aecarroll1009/Aj-s-Sunrise-Alarm/cad/out/view_core_front.png

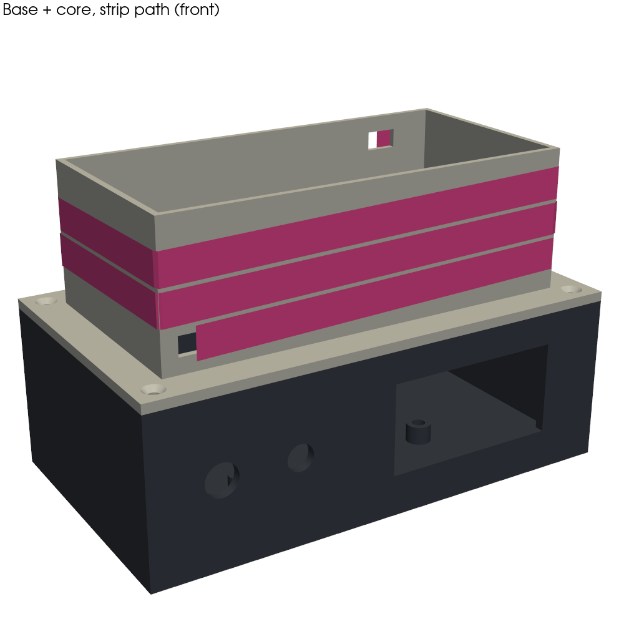
cad/out/view_core_front.png
