aecarroll1009/Aj-s-Sunrise-Alarm/cad/out/view_core_rear.png

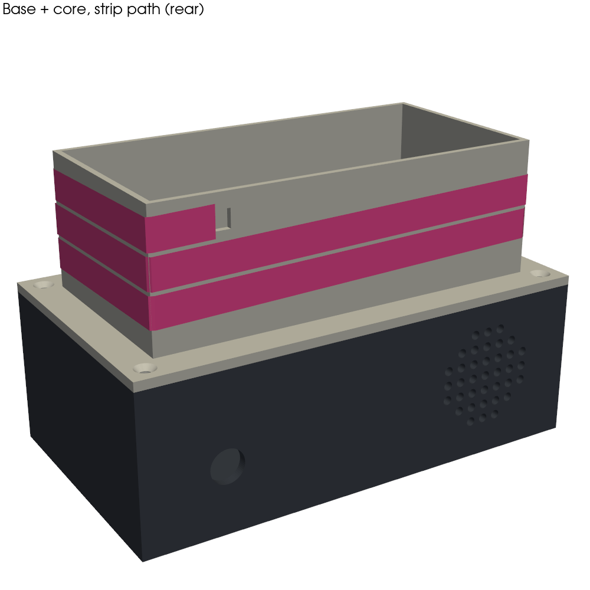
cad/out/view_core_rear.png
