aecarroll1009/Aj-s-Sunrise-Alarm/cad/out/view_exploded.png

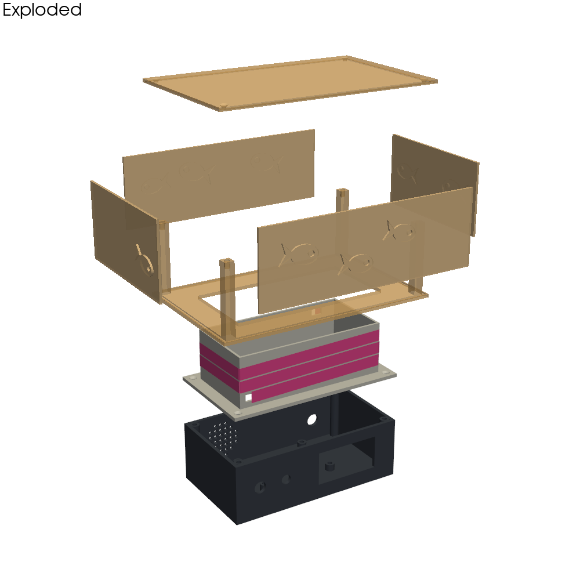
cad/out/view_exploded.png
