aecarroll1009/Aj-s-Sunrise-Alarm/cad/out/view_fish_layout.png

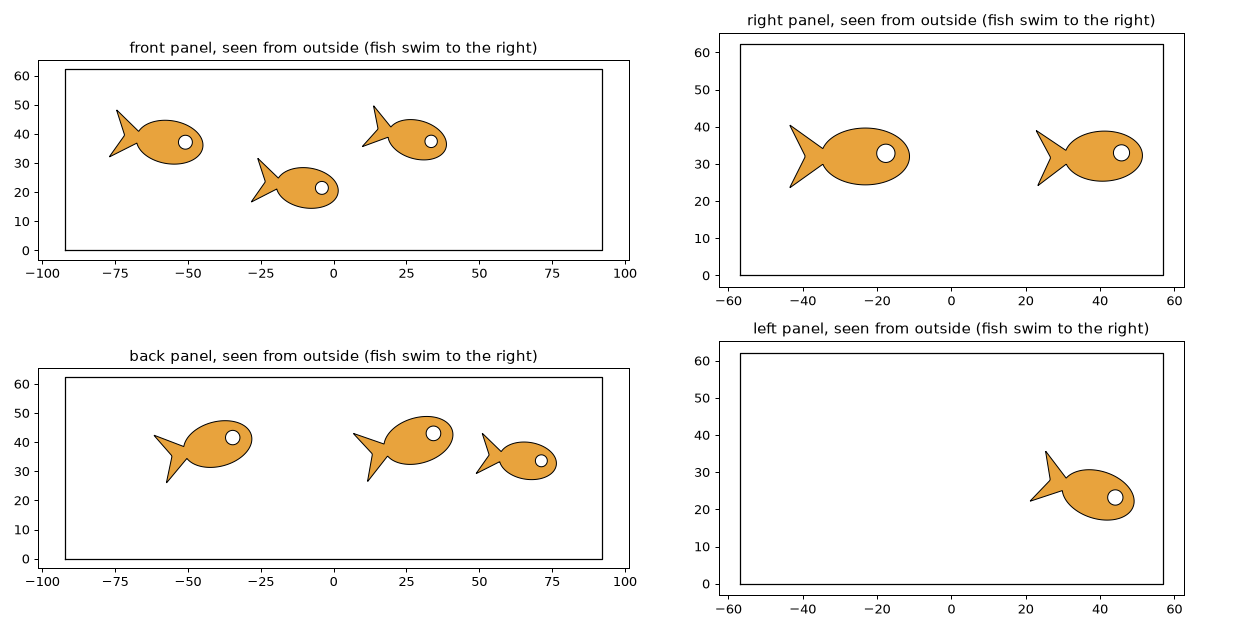
cad/out/view_fish_layout.png
