aecarroll1009/Aj-s-Sunrise-Alarm/cad/out/view_shade_under.png

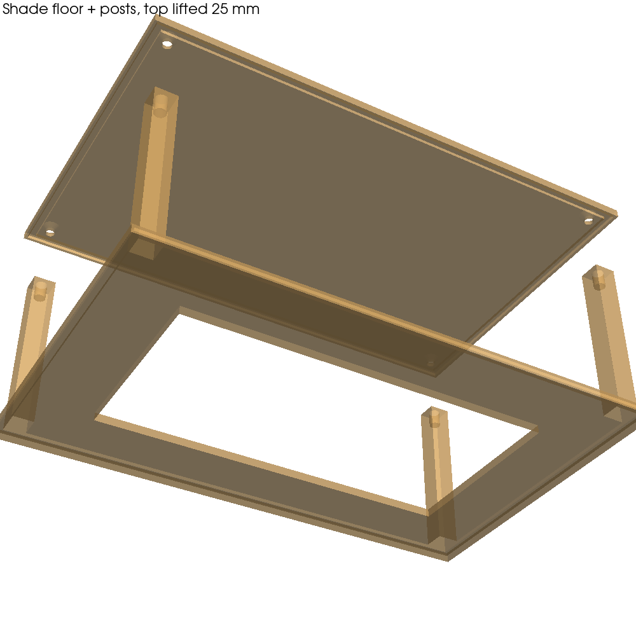
cad/out/view_shade_under.png
