aecarroll1009/Aj-s-Sunrise-Alarm/cad/out/view_side_back.png

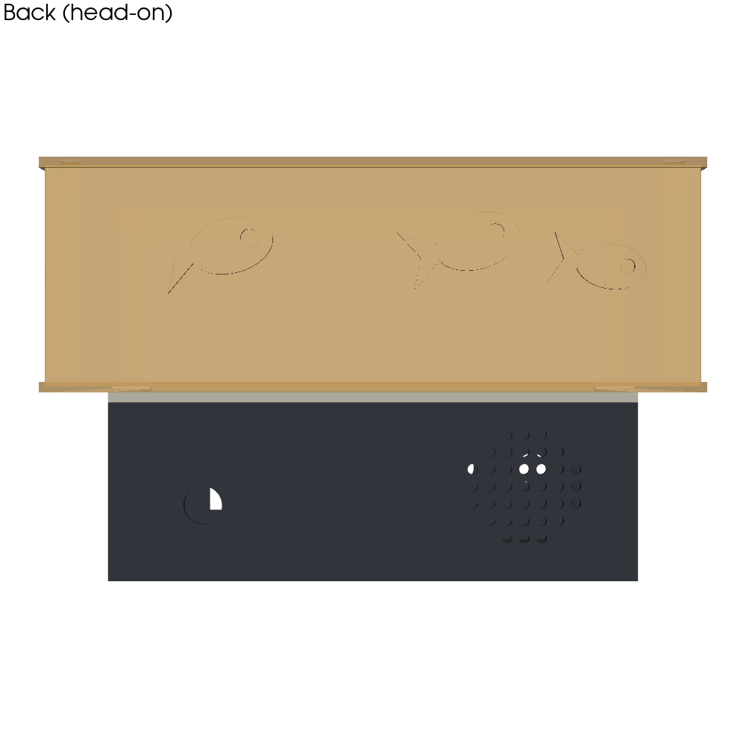
cad/out/view_side_back.png
