aecarroll1009/Aj-s-Sunrise-Alarm/cad/out/view_side_front.png

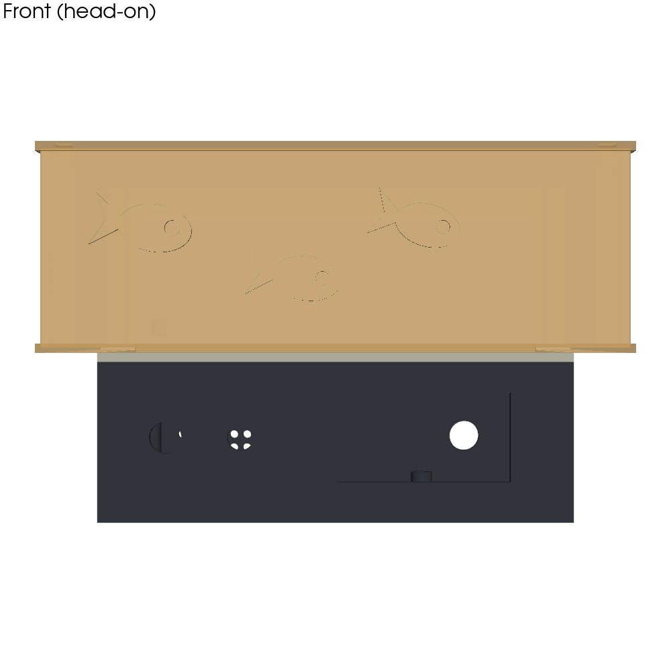
cad/out/view_side_front.png
