aecarroll1009/Aj-s-Sunrise-Alarm/cad/out/view_side_left.png

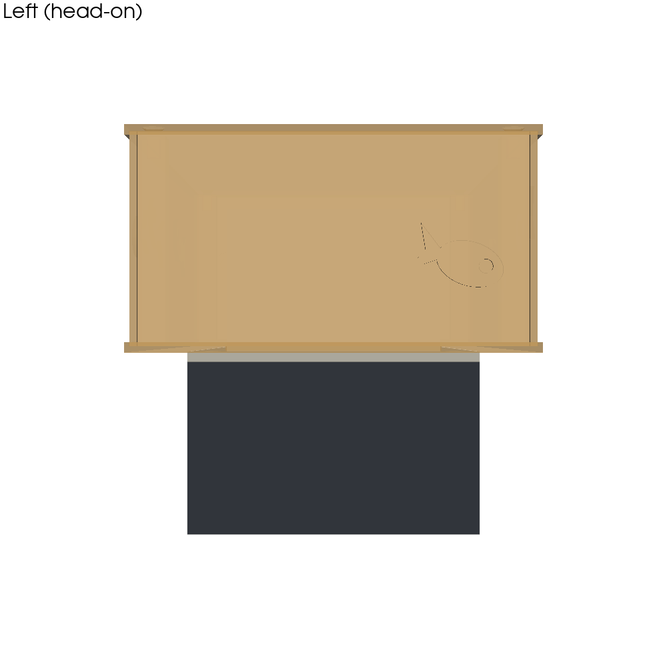
cad/out/view_side_left.png
