aecarroll1009/Aj-s-Sunrise-Alarm/cad/out/view_tub_inside.png

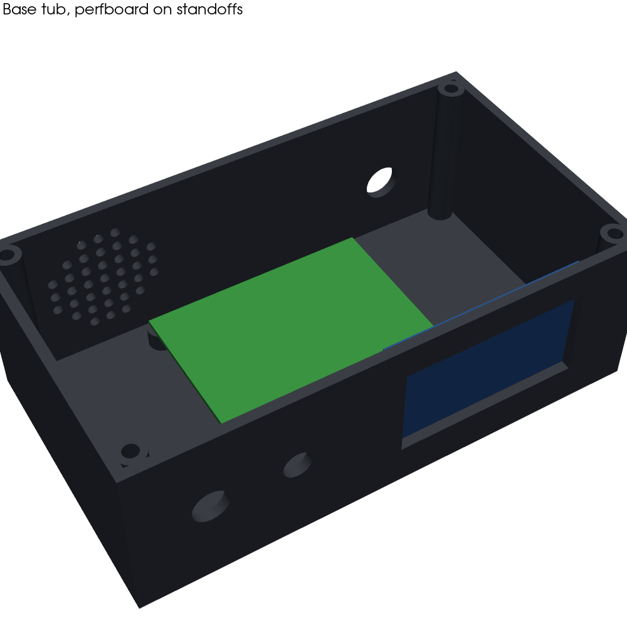
cad/out/view_tub_inside.png
