aecarroll1009/Aj-s-Sunrise-Alarm/cad/renders/view_fish_layout.png

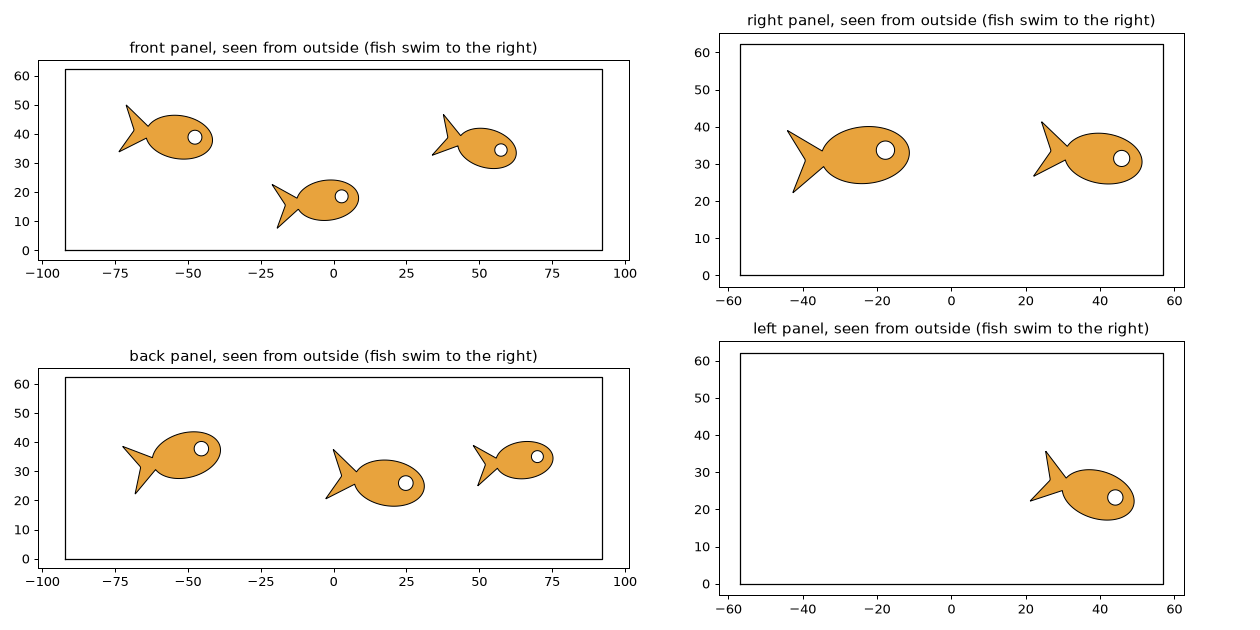
cad/renders/view_fish_layout.png
