aecarroll1009/Aj-s-Sunrise-Alarm/cad/assembly/assembly.step

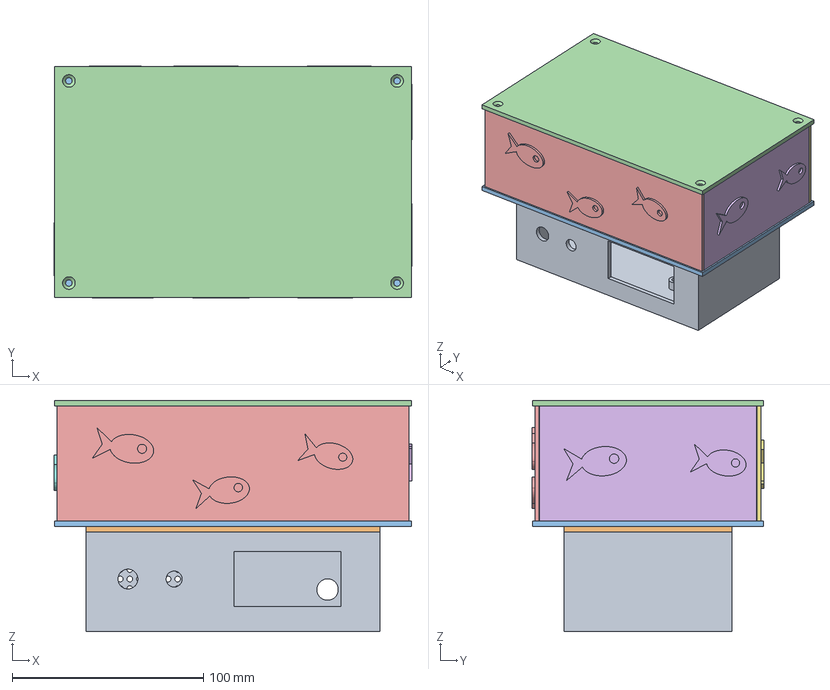
[picture p12: CAD file, 2026-11-01]
cad/assembly/assembly.step
187.4 x 121.4 x 121.0 mm
