aecarroll1009/Aj-s-Sunrise-Alarm/cad/fish/fish_edit_front.step

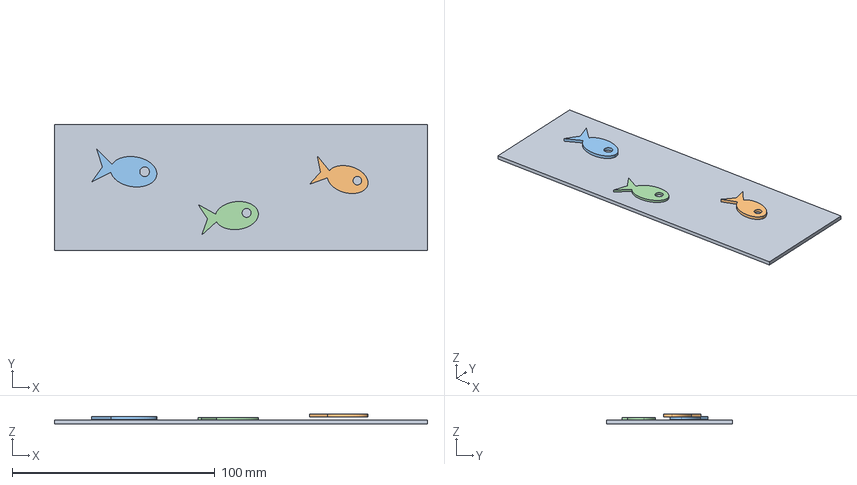
[picture p13: CAD file, 2026-11-01]
cad/fish/fish_edit_front.step
184.2 x 62.2 x 5.05 mm
plate
fish 1
fish 2
fish 3
