aecarroll1009/Aj-s-Sunrise-Alarm/cad/out/panel_left.step

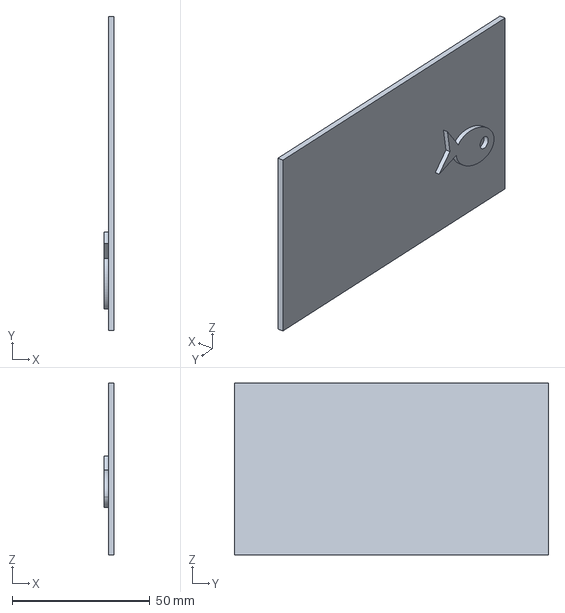
[picture p14: CAD file, 2026-10-31]
cad/out/panel_left.step
3.60 x 113.8 x 62.2 mm
