aecarroll1009/Aj-s-Sunrise-Alarm/cad/out/panel_front.step

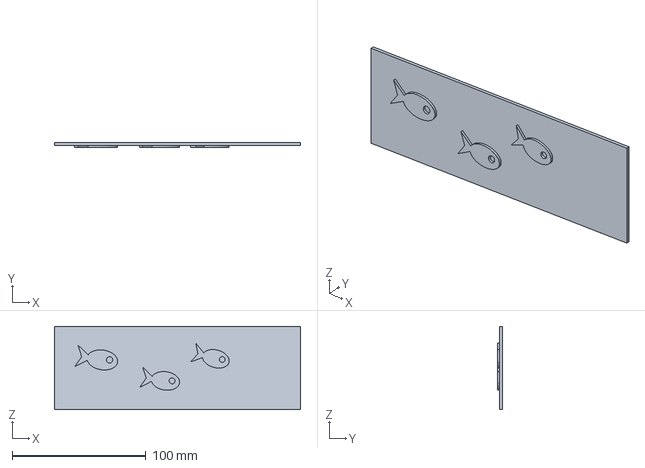
[picture p15: CAD file, 2026-10-31]
cad/out/panel_front.step
184.2 x 3.60 x 62.2 mm
