aecarroll1009/Aj-s-Sunrise-Alarm/cad/fish/fish_edit_back.step

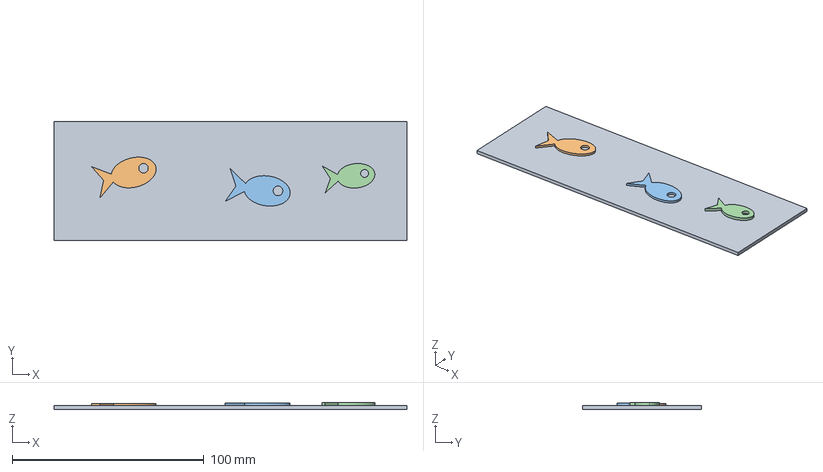
[picture p16: CAD file, 2026-11-01]
cad/fish/fish_edit_back.step
184.2 x 62.2 x 3.62 mm
plate
fish 1
fish 2
fish 3
