aecarroll1009/Aj-s-Sunrise-Alarm/cad/out/shade_top.step

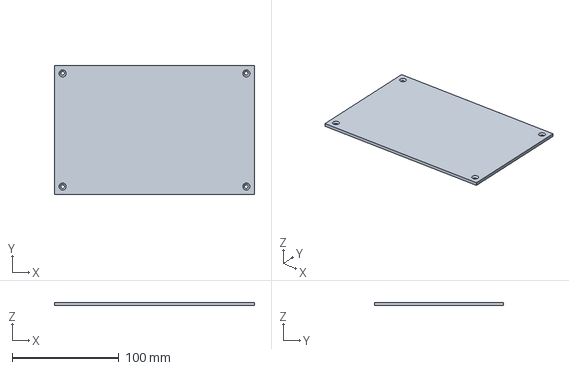
[picture p17: CAD file, 2026-10-31]
cad/out/shade_top.step
187.0 x 121.0 x 3.00 mm
