aecarroll1009/Aj-s-Sunrise-Alarm/cad/fish/fish_edit_right.step

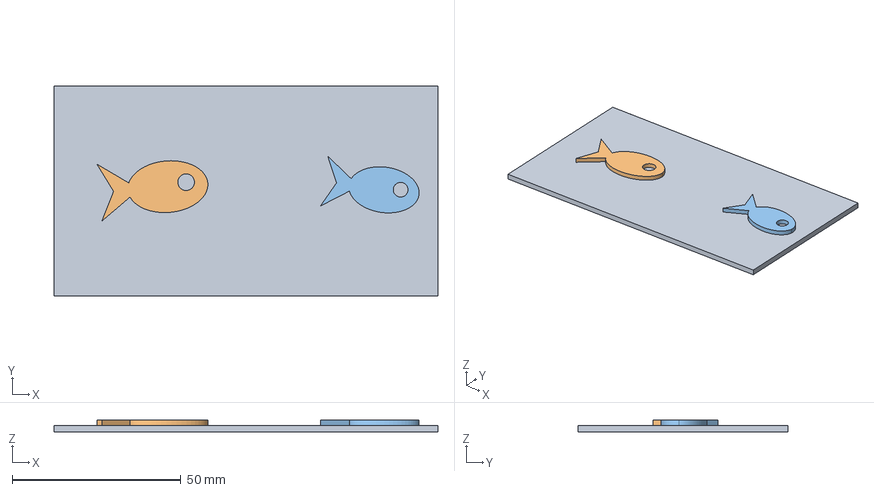
[picture p18: CAD file, 2026-11-01]
cad/fish/fish_edit_right.step
113.8 x 62.2 x 3.60 mm
plate
fish 1
fish 2
