aecarroll1009/Aj-s-Sunrise-Alarm/cad/out/deck_core.step

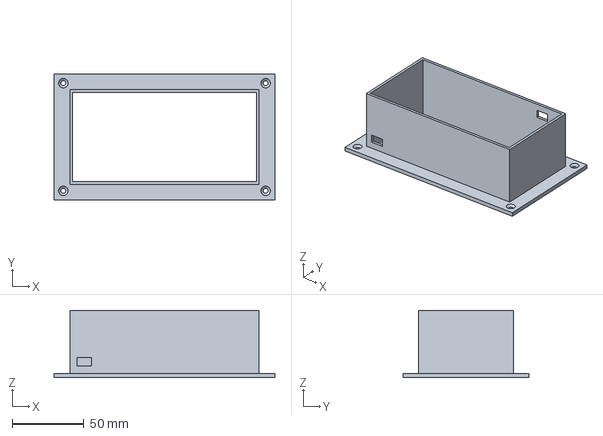
[picture p19: CAD file, 2026-10-31]
cad/out/deck_core.step
154.0 x 88.0 x 47.0 mm
