aecarroll1009/Aj-s-Sunrise-Alarm/cad/out/shade_floor.step

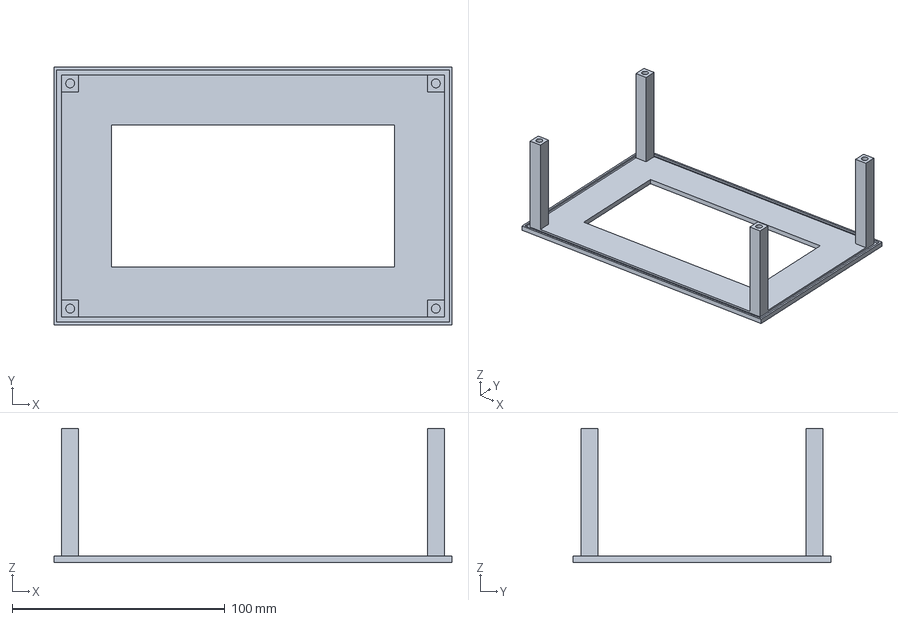
[picture p20: CAD file, 2026-10-31]
cad/out/shade_floor.step
187.0 x 121.0 x 63.0 mm
