aecarroll1009/Aj-s-Sunrise-Alarm/cad/out/base_tub.step

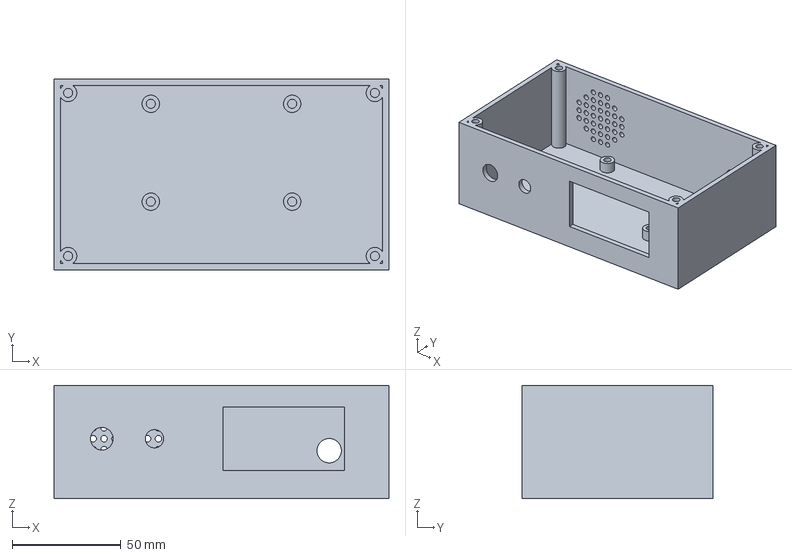
[picture p21: CAD file, 2026-10-31]
cad/out/base_tub.step
154.0 x 88.0 x 52.0 mm
