aecarroll1009/Aj-s-Sunrise-Alarm/cad/out/shade_shell.step

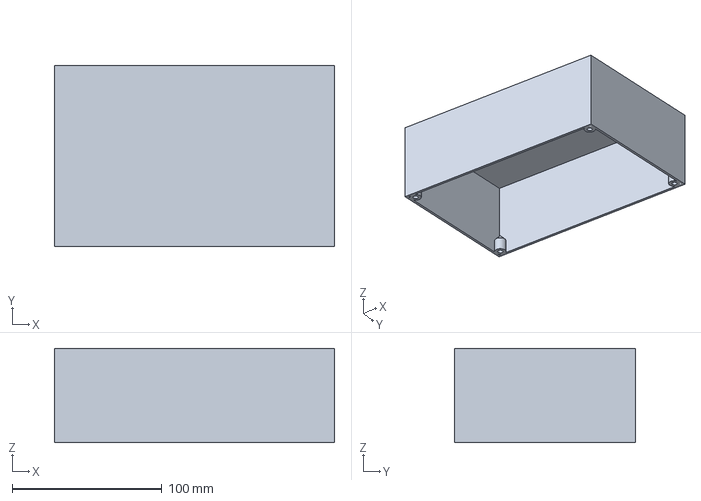
[picture p23: CAD file, 2026-10-31]
cad/out/shade_shell.step
187.0 x 121.0 x 63.0 mm
