aecarroll1009/Aj-s-Sunrise-Alarm/(list of files, cad)

Other CAD files:
cad/out/assembly.step
cad/to_print/panel_left.step
cad/fish/fish_edit_left.step
cad/to_print/panel_front.step
cad/to_print/shade_top.step
cad/to_print/panel_back.step
cad/to_print/shade_floor.step
cad/to_print/panel_right.step
cad/out/panel_right.step
cad/to_print/deck_core.step
cad/to_print/base_tub.step
cad/out/panel_back.step
cad/out/base_tub.stl
cad/out/deck_core.stl
cad/out/panel_back.stl
cad/out/panel_front.stl
cad/out/panel_left.stl
cad/out/panel_right.stl
cad/out/shade_floor.stl
cad/out/shade_frame.stl
cad/out/shade_shell.stl
cad/out/shade_top.stl
