aecarroll1009/Aj-s-Sunrise-Alarm/(commit log)

2026-07-04 Scaffold project structure for sunrise alarm firmware
    Multi-file layout matching the spec's subsystem breakdown: core logic
    modules (SunriseCurve, AlarmSequence, UIMenu, LightEngine) kept separate
    from hardware adapters (StripDriver, OledDriver, RtcDriver, DFPlayerDriver,
    InputDriver, Persistence) so the pure logic can be tested without a board.
2026-07-08 Implement + unit-test the pure-logic firmware core
    Fill in the three hardware-free modules from the spec (SS 4.2, 4.7, 4.8)
    and their native g++ test harness, plus the pin map / tunables in Config.h.
    - SunriseCurve: keyframe interpolation + quadratic PWM shaping, PWM-1 floor
    (no black->pop), endpoint clamping. Fixed curve, keyframes tuned on hardware.
    - LightEngine: LIGHT_OFF/MANUAL/SUNRISE, preset*brightness output, remembered
    brightness, authoritative alarm override.
    - AlarmSequence: SUNRISE->SOUNDING->SNOOZED state machine, dismiss/cancel at
    every stage, snooze-only-while-sounding, wrap-safe millis deadline, and pure
    helpers for the SS 4.9 hardware-flag trigger + power-loss recov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
    [AlarmSequence.cpp, AlarmSequence.h, Config.h, LightEngine.cpp, LightEngine.h, SunriseCurve.cpp, SunriseCurve.h, test_alarm_sequence.cpp]
2026-07-08 Add UIMenu state machine + tests; pin line endings
    UIMenu (spec SS 4.3-4.6) as pure logic emitting a view-model + commands:
    - HOME rotate=brightness (lamp on), short opens MENU.
    - MENU: Set Alarm / Set Time / Color Preset / Alarm on-off / Exit.
    - Set Alarm / Set Time field editors with the navigating-vs-editing chain,
    short-press advance, [Cancel] pseudo-field discard, long-press save-all.
    - Color Preset picker with the deliberately inverted grammar (rotate previews
    live, long saves, short reverts).
    - abortToHome() drops an uncommitted edit when the alarm takes over.
    Shared ClockHM/CalDate + UI tunables moved into Config.h.
    .gitattributes normalizes line endings (LF in repo; *.sh LF in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
    [Config.h, UIMenu.cpp, UIMenu.h, test_ui_menu.cpp]
2026-07-08 Implement hardware drivers, integration, and bring-up aids
    Fill in the 6 hardware adapters and wire the non-blocking main loop (spec SS 4.9),
    completing the firmware end to end. Also add standalone bring-up diagnostic
    sketches and a BRING_UP.md bench checklist for Seattle.
    Drivers:
    - StripDriver: NeoPixel RGBW; show() only when a pixel changed (fix 1/3).
    - OledDriver: U8g2 page-buffer render of every screen (SS 4.4) + HOME night-dim;
    static labels moved to PROGMEM to reclaim SRAM.
    - RtcDriver: DS3231 Alarm1 hardware flag + firedOnDate key (fix 2).
    - DFPlayerDriver: write-only, playback reconciled via the BUSY pin (fix 4).
    - InputDriver: ISR quadrature decode + debounced short/long/soft-po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
    [AJs_Sunrise_Alarm.ino, Config.h, DFPlayerDriver.cpp, DFPlayerDriver.h, InputDriver.cpp, InputDriver.h, OledDriver.cpp, OledDriver.h]
2026-10-31 Match firmware to the as-bought hardware
    - LED_COUNT 120 -> 60 for the 1 m strip; strip_test drives 60 px.
    - Replace OLED_IS_SH1106 with an OLED_DRIVER selector (SSD1306, SH1106,
    SSD1309), defaulting to the 2.42" SSD1309 I2C panel.
    - BRING_UP: 5 A blade fuse, OLED 5 V regulator check, SSD1309 fallback
    constructor note.
    - README: update hardware table and point to cad/.
2026-10-31 Add parametric 3D-printed enclosure
    build123d script for the blocky-mushroom enclosure: opaque base tub,
    deck with the LED core, and a translucent shade (shell + floor joined
    with M3 heat-set inserts). Includes front/rear cutouts sized to the
    measured encoder, button and DC jack, perfboard standoffs, and the
    strip-wrap calculation. Exports STEP/STL and preview renders to cad/out.
2026-10-31 Rework enclosure proportions and add geometry checks
    - Base 60 -> 50 mm and shade 80 -> 60 mm, then OUTER_SCALE 1.1 on the
    outside (187 x 121 x 121 mm overall); hole, insert, wall and screw
    sizes stay fixed.
    - Front face mirrored: soft-power button far left, encoder, OLED right.
    - Core height derived from strip length and pitch; switch to the 50x70
    perfboard set back behind the OLED module; clearance report in build.
    - Add check.py, which measures hole sizes, insert depths, screw reach
    and mating-hole alignment off the built solids.
2026-10-31 Goldfish panels and screw-free shade faces
    - Replace the one-piece shade shell with four flat side panels carrying
    raised cartoon goldfish (eye is a hole down to the panel); 3 front,
    2 right, 3 back, 1 left, all swimming counter-clockwise seen from above.
    Layout is seeded and non-overlapping.
    - Floor gains four slim corner posts with M3 inserts in their tops; a flat
    top plate screws down into them and clamps the panels, which sit in
    shallow recesses. The only visible screws are four flush heads on top.
    - Panel STLs export flat, fish up, for support-free printing.
    - check.py covers the new parts: no overlaps, eyes, swim direction,
    recess seating, top-plate screw reach and alignmen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
2026-11-01 Hand-placed fish layout and print-ready STEP folder
    Fish positions now round-trip through Fusion: fish_io.py exports each panel
    with the fish as separate bodies to cad/fish, and reads edited STEP files
    back into fish/layout.json, which the build uses.
    Outputs are split into to_print/ (one STEP per part, on the bed in print
    orientation), assembly/ and renders/, replacing out/.
